echen8888/Project-NUEVO/docs/ros2/README.md

# ROS2 Docs

Workspace-level ROS2 documentation lives here.

Use these files for stack-level design, setup, and testing notes:

- [`ros2_nodes_design.md`](ros2_nodes_design.md)
- [`bridge_runtime.md`](bridge_runtime.md)
- [`rpi_setup.md`](rpi_setup.md)
- [`integration_test.md`](integration_test.md)
- [`troubleshooting.md`](troubleshooting.md)
- [`uart_tlv_test.md`](uart_tlv_test.md)
- [`vision_node.md`](vision_node.md)

Package-local READMEs stay next to their code under `ros2_ws/src/...`.
