echen8888/Project-NUEVO/plot.png

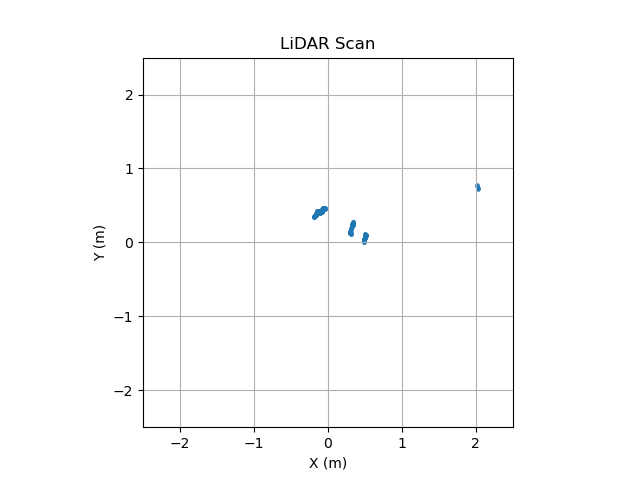
plot.png
