echen8888/Project-NUEVO/trajectory.png

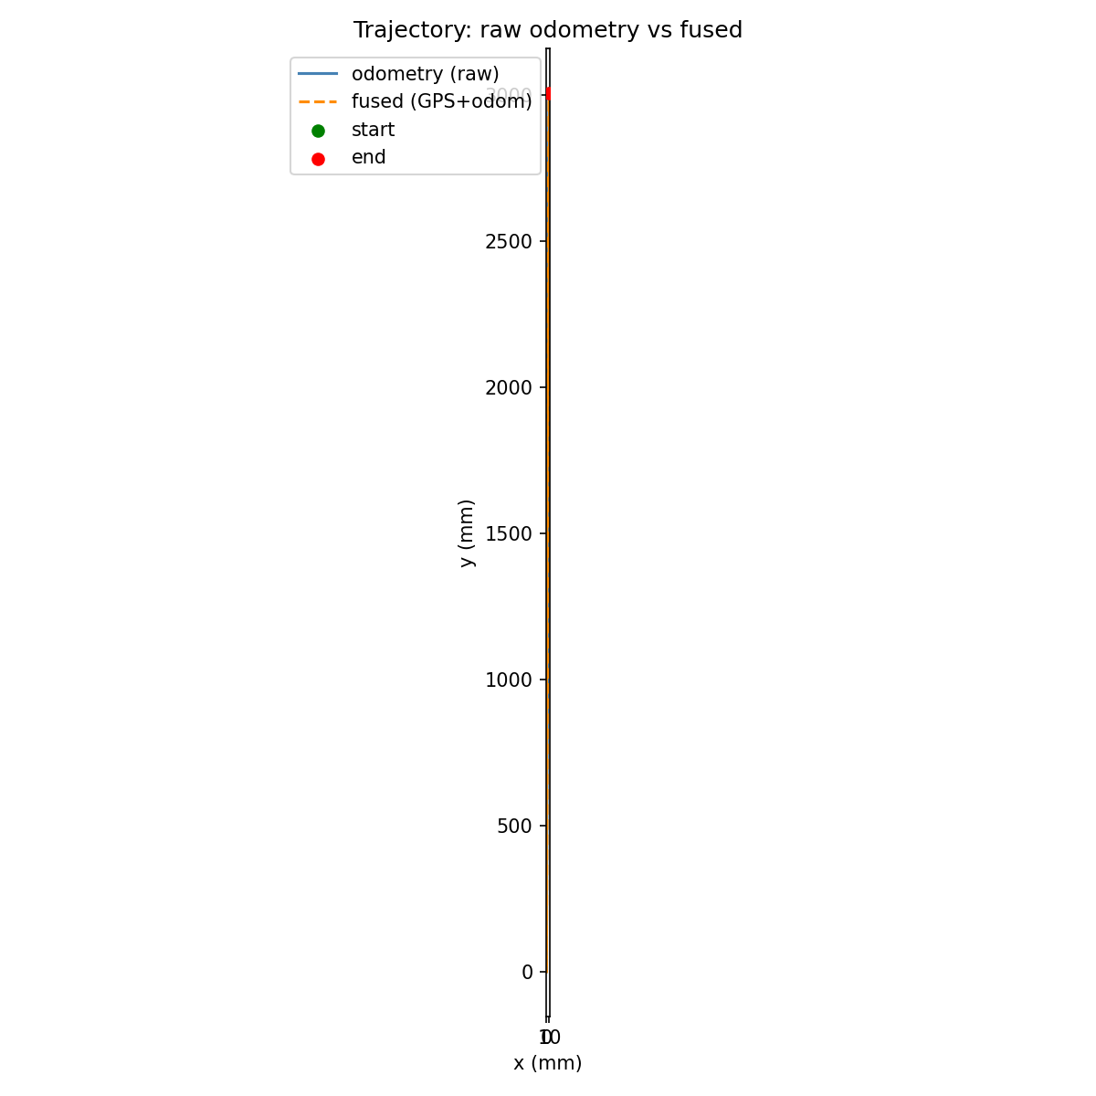
trajectory.png
