echen8888/Project-NUEVO/docs/lab_manual/Lab1_ROS2/lab1_manual_0.1.2.pdf

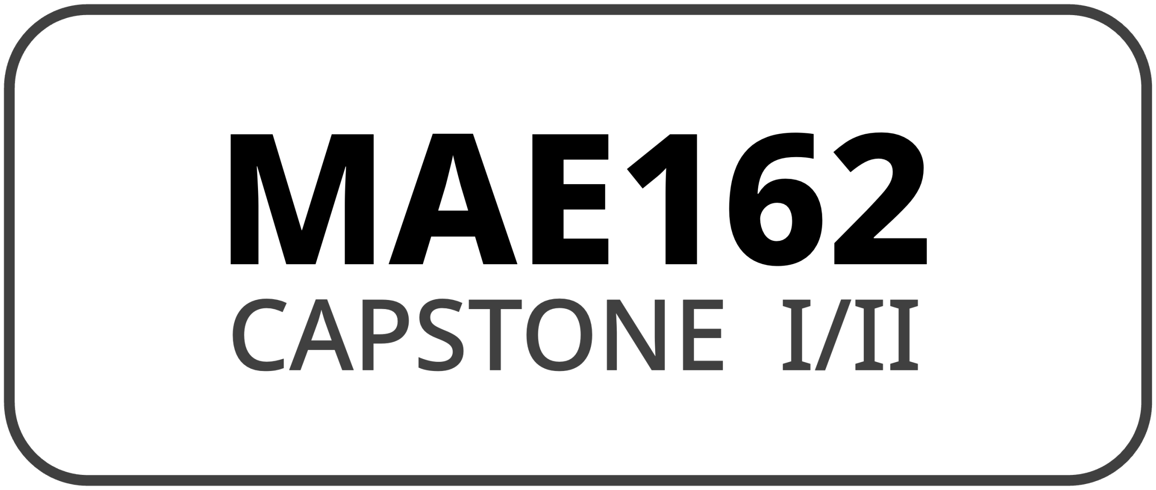
[picture p13: figure]

# Lab 1: ROS2 Introduction and System Integration

## Version 0.1.2

## 162 TAs and Maclab members

April 2, 2026

Warning!

- No food and drinks are allowed in the lab.
- Be careful with the hardware especially the electronics. Any liquid spill can cause a short circuit, potentially significantly delaying your progress.
- Never generate a short circuit.
- Connect electric wires only when you are sure about what you are doing.
- Be gentle to the buttons! You are liable to the damage made to the robot and its electronics.
- Wash your hands after each experiment, some components may contain some lead.
- Do not run experiments on the table for the chance the robot may fall on the floor and get damaged.

1

## Contents

1 System Architecture | 3
2 ROS2 Introduction | 6
3 Lab Activities | 8
3.3 Task 3: Bring Up the ROS2 Environment and NUEVO UI . . . . | 12
4 Lab Deliverables | 18

2

## 1 System Architecture

Figure 1 shows the full system architecture of Project NUEVO. The system is divided into several blocks that communicate over well-defined interfaces. Understanding this structure is essential for debugging and extending the robot. For a comprehensive reference covering all subsystems, see docs/manual/MANUAL.md. (https://github.com/pochihh/Project-NUEVO/blob/main/docs/manual/MANUAL.md)

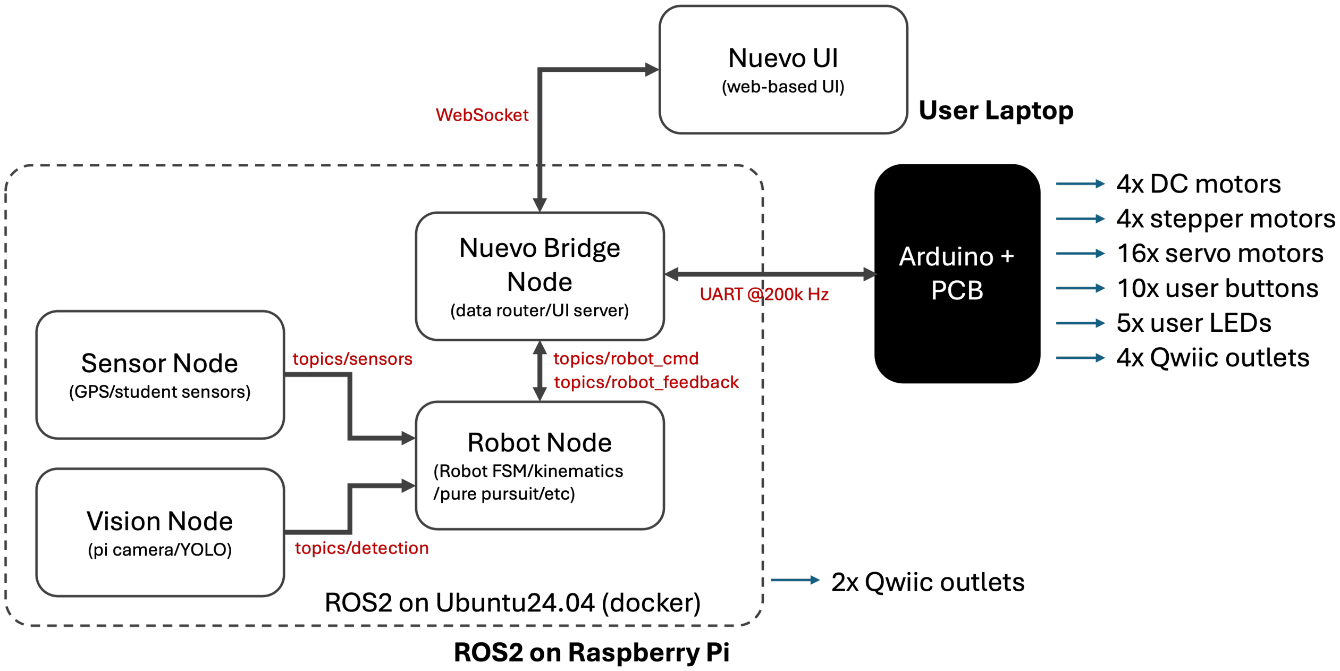
[picture p14: figure]

Figure 1: System Architecture.

PCB and Firmware

The custom PCB hosts an Arduino Mega 2560 microcontroller and breaks out the following hardware channels:

- 4 DC motor channels with quadrature encoder feedback
- 4 stepper motor channels (A4988/DRV8825 drivers)
- 16 servo channels via a PCA9685 I²C PWM controller
- IMU (ICM-20948: accelerometer, gyroscope, magnetometer)
- Voltage monitoring for the battery rail, 5 V rail, and servo rail
- User I/O: buttons, discrete LEDs, and NeoPixel RGB LEDs
- Limit switches and expandable ultrasonic sensor slots

3

The firmware is the only component that directly controls the actuators and reads hardware encoders; all other layers communicate with it through the bridge.

For full firmware details refer to:

- firmware/README.md (https://github.com/pochihh/Project-NUEVO/blob/main/firmware/README.md) — build, upload, and configuration overview
- firmware/arduino/src/config.h (https://github.com/pochihh/Project-NUEVO/blob/main/firmware/arduino/src/config.h) — all compile-time settings (channel counts, gains, rates)
- firmware/docs/architecture.md (https://github.com/pochihh/Project-NUEVO/blob/main/firmware/docs/architecture.md) — runtime task structure and startup order
- docs/COMMUNICATION_PROTOCOL.md (https://github.com/pochihh/Project-NUEVO/blob/main/docs/COMMUNICATION_PROTOCOL.md) — TLV protocol, message catalog, and state machine
- tlv_protocol/TLV_Payloads.md (https://github.com/pochihh/Project-NUEVO/blob/main/tlv_protocol/TLV_Payloads.md) — exact payload byte layouts and IDs

Bridge

The bridge is a Python process running on the Raspberry Pi 5. It owns the single UART connection to the Arduino (/dev/ttyAMA0 at 200 kbaud) and translates between the compact TLV wire protocol and higher-level interfaces. In addition to the transport layer, the bridge runs a FastAPI/WebSocket server that serves the NUEVO web UI. When running inside the ROS2 Docker container, the bridge also publishes and subscribes to ROS2 topics and services, acting as the boundary between the real-time firmware world and the robot application layer.

Refer to:

- ros2_ws/BRIDGE_RUNTIME.md (https://github.com/pochihh/Project-NUEVO/blob/main/ros2_ws/BRIDGE_RUNTIME.md) — bridge architecture, shared runtime model, and reset recovery
- docs/COMMUNICATION_PROTOCOL.md (https://github.com/pochihh/Project-NUEVO/blob/main/docs/COMMUNICATION_PROTOCOL.md) — TLV protocol, message catalog, and state machine

NUEVO UI

The NUEVO UI is a React web application served by the bridge backend. It provides a dashboard for testing and monitoring all hardware in real time:

4

motor speed setpoints and feedback, stepper positions, servo angles, LED color, user button states, IMU readings, voltage levels, and odometry. You access it from any browser on the same network by navigating to the Raspberry Pi’s IP address at port 8000.

Refer to:

- ros2_ws/README.md (https://github.com/pochihh/Project-NUEVO/blob/main/ros2_ws/README.md) — build instructions for the frontend and how to start the bridge that serves the UI

Robot Node

The robot ROS2 package is where high-level decision-making and path planning code lives. It subscribes to sensor and state topics published by the bridge, computes motion commands, and publishes velocity setpoints back to the bridge for execution. In this lab the robot node is a scaffold; you will extend it in future labs.

Sensor Node

The sensors ROS2 package handles Raspberry Pi–connected sensors that are not part of the Arduino firmware, such as GPS receivers and external range sensors (LiDAR, ultrasonic modules, etc.). It publishes sensor data as ROS2 topics for the robot node to consume.

Vision Node

The vision ROS2 package handles the camera pipeline and object detection. It reads frames from the camera, runs inference (e.g. YOLO), and publishes detection results as ROS2 topics. The vision dependencies (OpenCV, libcamera, YOLO) are heavier than the rest of the stack and are added to the Docker image separately.

Refer to the following for the Robot, Sensor, and Vision nodes:

- ros2_ws/ROS2_NODES_DESIGN.md (https://github.com/pochihh/Project-NUEVO/blob/main/ros2_ws/ROS2_NODES_DESIGN.md) — package layout, design principles, and topic/service naming
- ros2_ws/README.md (https://github.com/pochihh/Project-NUEVO/blob/main/ros2_ws/README.md) — Docker workflow, node startup order, and ROS2 API overview

5

Why ROS2 and Docker?

With this architecture, each component has a single responsibility and communicates through a standardised message-passing system. Adding a new sensor, planner, or perception algorithm means writing a new node that subscribes and publishes standard topics — the rest of the system does not change. Docker ensures that every team member and every Raspberry Pi runs the exact same software environment regardless of the host operating system, eliminating “it works on my machine” problems and making deployment to the robot a one-command step.

## 2 ROS2 Introduction

### 2.1 Core Concepts

ROS2 (Robot Operating System 2) is an open-source middleware framework for building robot software. Despite the name it is not an operating system: it is a set of libraries, tools, and conventions that run on top of a standard OS and let independently developed programs communicate with each other cleanly.

Nodes are the basic executable units. Each node is a process (or a thread within a process) that performs one focused task — reading a sensor, running a controller, publishing odometry. In this project: bridge, robot, sensor_node, and vision_node are each a separate node.

Topics are named communication channels that carry a stream of messages. A node that produces data publishes to a topic; a node that needs that data subscribes to it. Topics are asynchronous and many-to-many. For example, the bridge node publishes DC motor state on /dc_state_all and the robot node subscribes to that topic.

Messages define the data structure for a topic. They are declared in .msg files inside the bridge_interfaces package and compiled into languagespecific code automatically. bridge_interfaces/msg/DCStateAll and bridge_interfaces/msg/SystemPower are examples used in this project.

Services are synchronous request–reply interactions. A node that handles a service advertises it; another node calls it and waits for a response. Use services for discrete operations where you need to know whether the action

6

succeeded. In this project, firmware state transitions (IDLE → RUNNING, triggering an E-stop) use the /set_firmware_state service.

Packages are the unit of organisation and distribution. A package groups related nodes, message definitions, and launch files. This project has five packages: bridge_interfaces (message/service definitions), bridge (ROS wrapper around the firmware bridge), robot (motion planning), sensors (Pi-side sensors), and vision (camera and detection).

Keywords for further learning: ROS2 publisher/subscriber, colcon build, ros2 topic echo, ros2 node info, QoS policies, launch files, parameter server, tf2 transforms, RViz2, rqt.

### 2.2 Docker for ROS2

Modern robots are developed by teams working on different machines with different operating systems — macOS, Windows, Ubuntu. ROS2 Jazzy officially targets Ubuntu 24.04; running it natively on macOS or Windows requires significant manual setup that is fragile and hard to reproduce. Docker solves this by packaging the entire ROS2 environment — OS libraries, ROS installation, workspace build — into a single container image. Everyone on the team starts the same image, so the software environment is identical whether you are developing on a laptop or deploying to the Raspberry Pi. This also means updating the environment is a docker compose build rather than a multi-step manual procedure.

In this project the Docker image contains ROS2 Jazzy, the project workspace, and all Python runtime dependencies. Two compose files are provided:

- ros2_ws/docker/docker-compose.rpi.yml — for the Raspberry Pi with real hardware
- ros2_ws/docker/docker-compose.vm.yml — for macOS / Windows development (mock bridge)

Keywords for further learning: Dockerfile, Docker image vs. container, docker compose, volume mounts, container networking, docker exec, base images.

7

## 3 Lab Activities

### 3.1 Task 1: Set Up Your Repository

Where to run: | Laptop | your laptop | | RPi | Raspberry Pi | | The repo must be cloned
on both machines. Your laptop uses it for firmware (Task 2); the RPi uses it for ROS2 (Task 3). Day-to-day edits are made on your laptop, then pulled onto the RPi.

In this course you will modify the Project NUEVO codebase to add features and tune your robot. Each team should work in their own copy of the repository so that your changes do not affect other teams and so you can safely experiment.

### 1.1 Fork the Repository Laptop

1. Go to github.com/pochihh/Project-NUEVO.
2. Click Fork (top-right corner) to create a copy under your own GitHub
account. | (keyword: fork)
3. On your forked repository page, go to Settings → Collaborators and add your teammates as collaborators so everyone can push to the same
fork. | (keyword: collaborators, repository permissions)
1.2 Clone the Repository — Laptop | Laptop

Clone your fork onto your laptop. You will use this copy to edit firmware, run MATLAB, and push changes to GitHub.

git clone https://github.com/<your-username>/Project-NUEVO.git cd Project-NUEVO

(keyword: clone, remote)

### 1.3 Clone the Repository — Raspberry Pi RPi

SSH into the Raspberry Pi and clone the same fork there. The RPi copy is what Docker mounts when running the ROS2 workspace in Task 3.

8

git clone https://github.com/<your-username>/Project-NUEVO.git cd Project-NUEVO

You do not normally edit code directly on the RPi. The typical workflow is: edit on your laptop → commit → push to GitHub → git pull on the RPi to bring in the latest changes. You can make local changes on the RPi and push them back to GitHub if needed, but be careful not to let the two clones diverge—always pull on one machine before editing, and push promptly so your teammates stay in sync.

Important: the Raspberry Pi is embedded hardware and can lose power unexpectedly, suffer SD card corruption, or need to be re-imaged at any time. Any work that exists only on the RPi can be lost without warning. Push every change to GitHub as soon as you make it. Never leave uncommitted or unpushed work sitting on the RPi.

### 1.4 Daily Git Workflow Laptop

Git lets your whole team work on the same codebase simultaneously. Run these commands on your laptop:

1. Stage the files you want to save.

git add <filename>

(keyword: staging area, working tree)

2. Commit to record a snapshot with a short message describing what you did.

git commit -m "brief description of change"

(keyword: commit, commit message)

3. Push to upload your commits to GitHub so teammates (and the RPi) can see them.

9

git push

(keyword: push, origin)

4. Pull to download your teammates’ latest commits before you start working.

git pull

(keyword: pull, merge, rebase, merge conflict)

### 1.5 Pull Updates from the Original Repository Laptop

Bug fixes and new features will be released to the original repository during the course. To bring them into your fork, add the original repository as a second remote and pull from it:

1. Add the original repository as the upstream remote (one-time setup):

git remote add upstream https://github.com/pochihh/Project-NUEVO.git

(keyword: remote, upstream)

2. Fetch and merge the latest changes from upstream into your local branch (for updates in the future):

git fetch upstream
git merge upstream/main

(keyword: fetch, merge, fast-forward)

3. Push the merge result (the updates) to your fork:

git push

10

### 3.2 Task 2: Flash the Firmware

Where to run: | Laptop | your laptop | | Arduino IDE is installed on your laptop; the
Arduino is connected via USB.

The Arduino Mega firmware must be flashed onto the robot before the bridge can communicate with it. Full details and troubleshooting are in firmware/ README.md. (https://github.com/pochihh/Project-NUEVO/blob/main/firmware/README.md)

### 2.1 Prerequisites Laptop

1. Install Arduino IDE 2.x and the Arduino AVR Boards core.
2. Increase the serial buffer size so the firmware UART link does not overflow. Create or edit (if exists already) platform.local.txt for the installed AVR core and add the following text in it:

compiler.cpp.extra_flags=-DSERIAL_RX_BUFFER_SIZE=512 ,→ -DSERIAL_TX_BUFFER_SIZE=256

Typical file locations (replace 1.8.7 with your installed AVR core version):

macOS:

~/Library/Arduino15/packages/arduino/hardware/avr/1.8.7/platform.local. ⌋ ,→ txt

Windows:

C:\Users\<your-user>\AppData\Local\Arduino15\packages\arduino\hardware\ ⌋
,→ | avr\1.8.7\platform.local.txt
2.2 Build and Upload | Laptop
1. Open firmware/arduino/arduino.ino in Arduino IDE.
2. Select board: Arduino Mega or Mega 2560.

11

3. Select the correct COM / serial port for the connected Arduino.
4. Click Verify to confirm the firmware compiles without errors.
5. Click Upload to flash the firmware onto the board.

After a successful upload the board resets and the firmware starts running. Confirm by opening the Arduino IDE Serial Monitor at 115 200 baud and checking for heartbeat output.

### 3.3 Task 3: Bring Up the ROS2 Environment and NUEVO UI

Where to run: | RPi | Raspberry Pi (SSH or direct terminal) | | Steps 3.1–3.6 run
on the RPi. Step 3.7 opens in a browser on any device on the same network. Make sure you have already cloned your fork on the RPi (Task 1.3) and run git pull to get the latest code before starting.

In this task you will start the Docker container on the Raspberry Pi, launch the bridge node, and verify all hardware using the NUEVO web UI. Full setup details are in ros2_ws/README.md. (https://github.com/pochihh/Project-NUEVO/blob/main/ros2_ws/README.md)

### 3.1 Raspberry Pi UART Setup (one-time) RPi

The bridge communicates with the Arduino over the RPi hardware UART. Enable it by editing the RPi boot configuration files:

1. Add the following lines to /boot/firmware/config.txt:

enable_uart=1
dtoverlay=uart0-pi5
2. Remove any console=serial0 or console=ttyAMA0 entries from /boot/firmware/cmdline.txt so the OS does not claim the port.
3. Reboot and verify: ls -l /dev/ttyAMA0 should show a character device owned by the dialout group.

### 3.2 Install Node.js and npm (one-time) RPi

The NUEVO UI frontend build uses npm. Install Node.js and npm on the Raspberry Pi host first:

12

sudo apt update
sudo apt install -y nodejs npm node -v
npm -v

For this project, node -v should report a reasonably modern version (Node 18 or newer is a safe baseline).

### 3.3 Build the Frontend (one-time) RPi

The bridge serves the NUEVO web UI as a pre-built static bundle. Build it once from the repository root:

cd nuevo_ui/frontend
npm ci
npm run build
cd ../..
cp -r nuevo_ui/frontend/dist/. nuevo_ui/backend/static/

### 3.4 Install Docker (one-time) RPi

For this class project, the simplest Docker setup on the Raspberry Pi is the official Docker convenience script:

curl -fsSL https://get.docker.com -o get-docker.sh sudo sh get-docker.sh
sudo usermod -aG docker $USER
newgrp docker
docker --version
docker compose version

Note: if newgrp docker does not take effect cleanly in your shell, log out and log back in once, then re-run the version checks above.

13

### 3.5 Start the Docker Container RPi

From the repository root on the Raspberry Pi:

COMPOSE=ros2_ws/docker/docker-compose.rpi.yml docker compose -f $COMPOSE build
docker compose -f $COMPOSE up -d
docker compose -f $COMPOSE logs -f ros2_runtime

Wait until the log shows that colcon build finished and the container is ready.

### 3.6 Launch the Bridge Node RPi

Open a shell inside the running container and start the bridge:

docker compose -f $COMPOSE exec ros2_runtime bash source /opt/ros/jazzy/setup.bash
source /ros2_ws/install/setup.bash
ros2 run bridge bridge

The bridge node connects to the Arduino, starts the WebSocket server, and begins publishing ROS2 topics.

### 3.7 Access the NUEVO UI UI (browser)

Open a browser on any device on the same network and navigate to:

http://<raspberry-pi-ip>:8000

Login credentials: username user, password 162. Change your password after first login.

Use the UI to test each hardware feature:

- Set stepper motor positions and verify movement.
- Command servo angles and observe the mechanical response.
- Change LED colors via the colour picker.
| 14

- Press each user button and confirm the indicator updates.
- Check IMU readings (accelerometer, gyroscope) for expected values.
- Monitor the battery voltage level on the power panel.

### 3.4 Task 4: DC Motor PI Tuning and Step Response

Where to run: | Laptop | your laptop | | UI (browser) | NUEVO UI | | RPi | RPi | | MATLAB
analysis and gain calculations run on your laptop. Motor commands and data recording use the NUEVO UI in your browser. The RPi must be running the bridge node from Task 3.

In this task you will tune the PI velocity controller for one DC motor and record step responses to evaluate your design. The goal is to transition from the default gains to a set of gains that you can justify from a simple model of the motor dynamics.

4.1 Model-Based PI Design (Optional) | UI (browser) | Laptop

A DC motor’s velocity dynamics can be approximated as a first-order linear system:
G(s) = | K
| | | τs + 1 | | | | (1)

where K is the steady-state gain (ticks/s per PWM unit) and τ is the time constant (seconds). You can identify both parameters from an open-loop step response.

Step 1: Measure the open-loop step response. In the NUEVO UI, switch the motor to PWM mode and apply a step change in PWM from 0 to a fixed value (e.g. 128 out of 255, or about 50 %). Record the velocity ω(t) response using the UI’s plot feature.

From the recorded curve:

- K = ωss/u where u is the actual integer PWM value you applied (0–255, not 1). For example, if you applied PWM = 128 and the motor settled at ωss = 980 ticks/s, then K = 980/128 ≈ 7.66 ticks/s per PWM unit.
- τ = the time at which ω(t) first reaches 63.2 % of ωss (read directly from the step-response plot).
| | | 15

Step 2: Design the continuous-time PI gains. A PI controller C(s) = Kp + Ki/s with plant G(s) gives a second-order closed-loop response. Matching coefficients to the standard form s

2 + 2ζωns + ω

2
n

yields:

Kp =

2ζωnτ − 1
K

, Ki =

ω

2
n

τ
K

(2)

Choose a desired damping ratio ζ = 0.7 (a good default that balances speed and overshoot). Select ωn based on a rise-time or settling-time specification of your choice, then compute Kp and Ki from Equations (2).

Step 3: Convert to discrete time. The firmware PI controller runs at fs = 200 Hz, so the sample period is Ts = 1/200 = 0.005 s. Because the gains from Step 2 are continuous-time, they must be discretized before they can be entered into the firmware. Use the Tustin (bilinear) transform, which substitutes
s −→
2 Ts | z − 1 z + 1

and maps the continuous-time PI controller to a discrete difference equation. In MATLAB, the conversion is one line:

Ts = 0.005; | % sample period (s) -- 200 Hz
C_s = pid(Kp, Ki); | % continuous-time PI
C_z = c2d(C_s, Ts, 'tustin'); | % discretize via bilinear transform
display(C_z) | % inspect the result

The resulting C_z object contains the discrete-time coefficients. You can extract the numerator and denominator and verify the DC gain matches Kp + Ki/(jω) at low frequency. The firmware implements the equivalent difference equation internally; you only need to enter Kp and Ki (the continuous-time values) through the UI—the firmware’s built-in discretization handles the rest at runtime.

### 4.2 Simple Observation (Alternative to 4.1) UI (browser)

If you prefer a faster approach, skip the model identification and instead adjust Kp and Ki manually while observing the step response: increase Kp to speed up the response, increase Ki to eliminate steady-state error, and reduce both if the response oscillates.

16

4.3 Record and Compare Step Responses | UI (browser) | Laptop

Using the NUEVO UI, command a velocity step from 0 to 1000 ticks/s and record the response for:

1. The default PI gains (as shipped in firmware/arduino/src/ config.h).
2. Your tuned gains from Task 4.1 or 4.2.

On each plot, annotate:

- Rise time tr (time to go from 10 % to 90 % of the setpoint)
- Percent overshoot Mp
- Settling time ts (time to stay within ±5 % of the setpoint)
- Steady-state error ess

Figure 2 shows an example plot.


Figure 2: Example annotated velocity step response (0 → 1000 ticks/s). The shaded region is the ±5 % settling band.

17

## 4 Lab Deliverables

Show your final step response plots to the TAs. Your plots should include both the default and tuned step responses with the performance metrics annotated. Justify your tuned gains: explain how you arrived at your Kp and Ki values, whether through the model-based approach or manual tuning, and discuss the trade-offs you observed between rise time, overshoot, and settling time.

18
