echen8888/Project-NUEVO/docs/lab_manual/Lab1_ROS2/dc_motor_1_0331_15-28_step_response.png

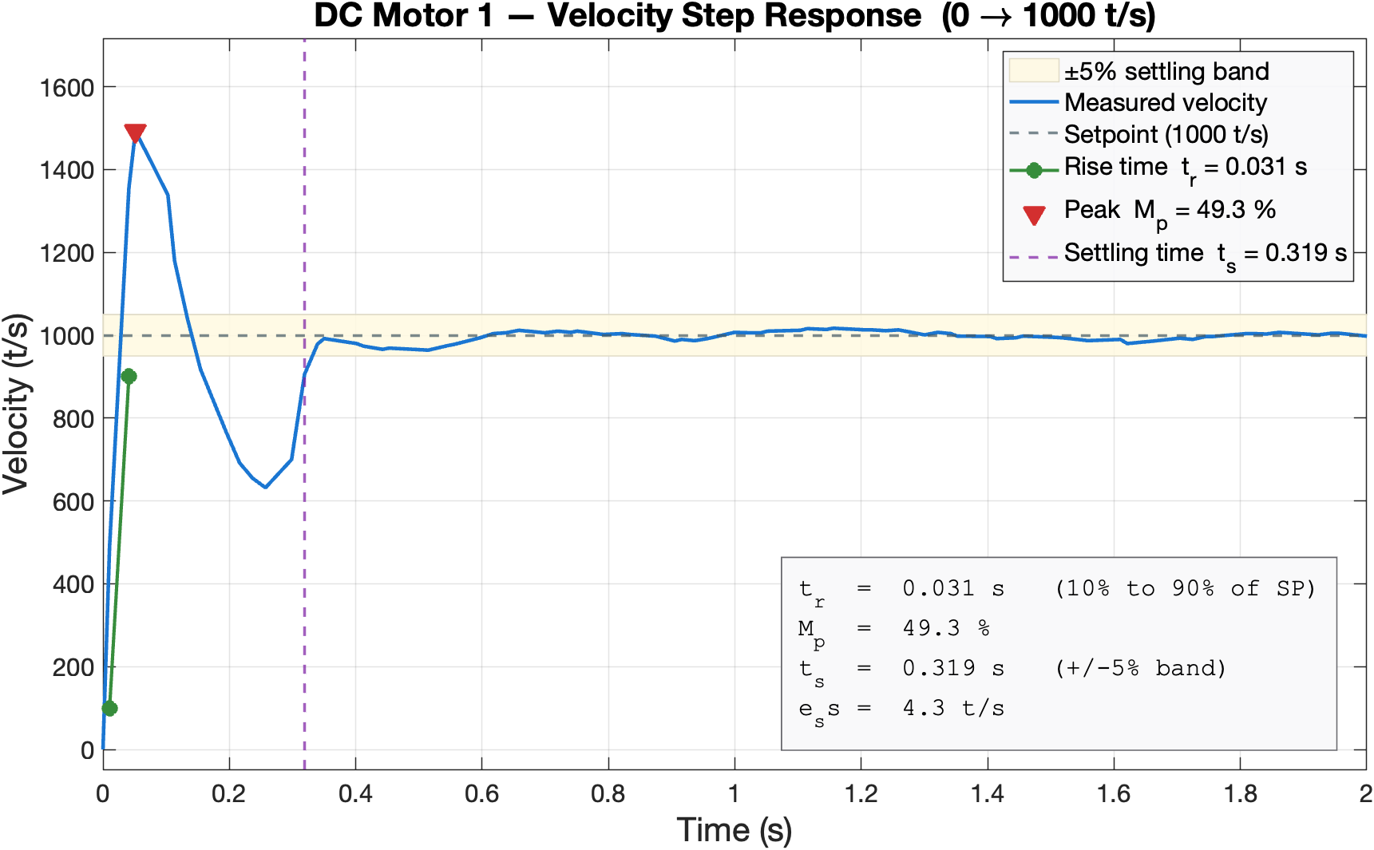
docs/lab_manual/Lab1_ROS2/dc_motor_1_0331_15-28_step_response.png
