echen8888/Project-NUEVO/orientation_fusion_test_result.png

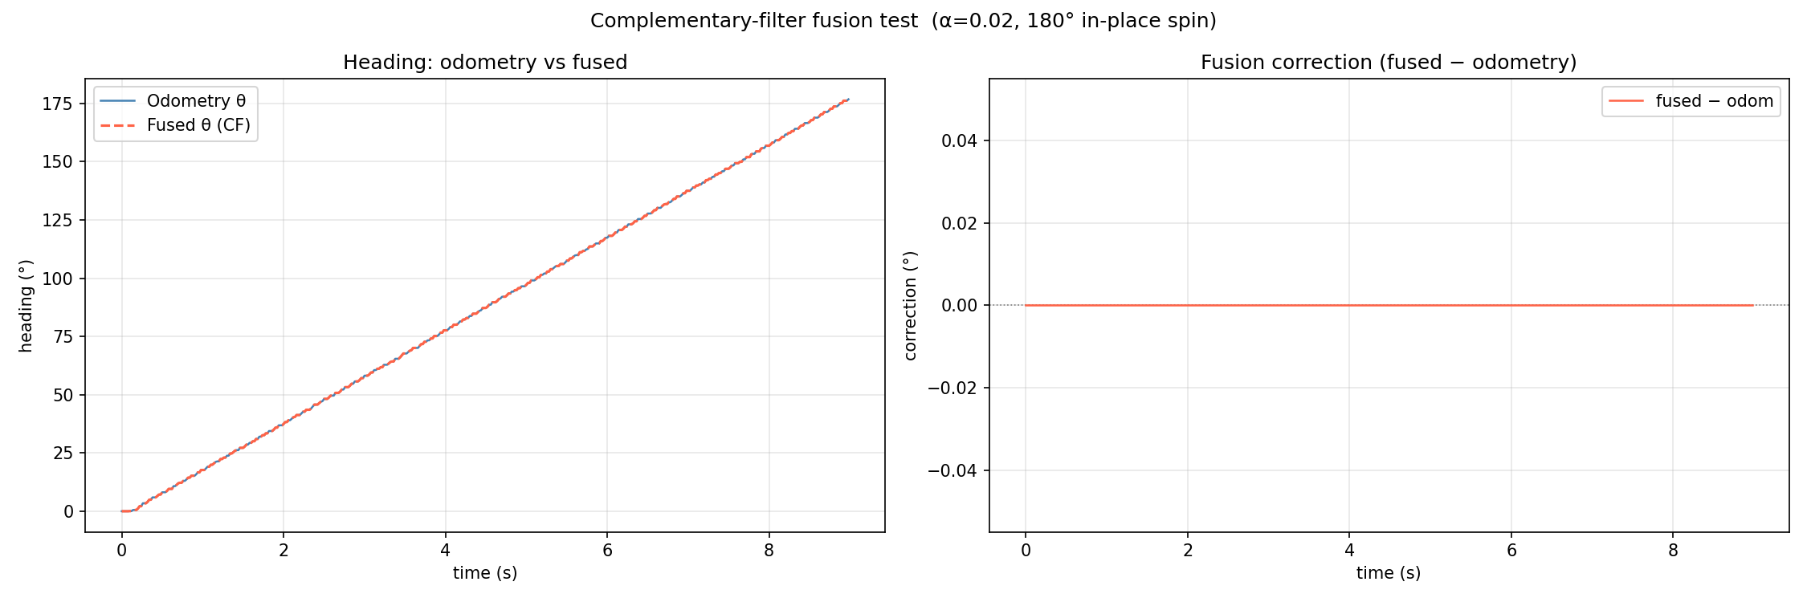
orientation_fusion_test_result.png
