echen8888/Project-NUEVO/ros2_ws/src/robot/robot/ai_codegen/test_UML.png

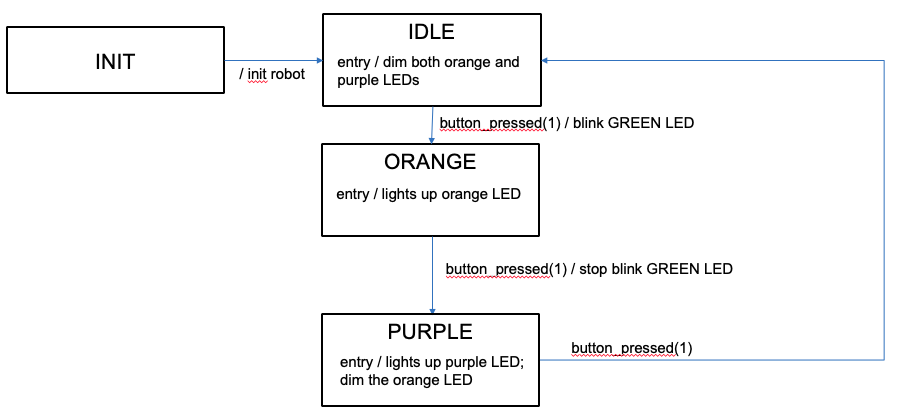
ros2_ws/src/robot/robot/ai_codegen/test_UML.png
