echen8888/Project-NUEVO/(commit log)

2026-01-28 updated UART python test code
2026-03-25 frontend motor overrun indication fix
2026-04-04 Add odom param query/response across the bridge, ROS, and UI. Expose the runtime odometry config in the robot API and odometry panel.
2026-04-04 Document the odom param query path. Clarify the odometry task cadence and the new robot API readback calls.
2026-04-08 Fix robot odometry parameter names and lab setup
    [main.py]
2026-04-19 New pi camera streaming solution first try. See "v4l2_loopback_camera_plan.md" for the plan details
2026-04-22 Use YOLO26n NCNN for vision node
    [model.ncnn.param, yolov4.cfg]
2026-05-01 add FusedPose and LidarWorldPoints message types
    New bridge_interfaces messages for the lidar canvas and GPS fusion UI:
    - FusedPose: world-frame x/y/theta + gps_active flag
    - LidarWorldPoints: parallel float arrays for efficient world-frame scan relay
2026-05-01 fix sensor_msgs import fallback and test module path
    - robot.py: wrap sensor_msgs.msg.LaserScan import in try/except so the
    module loads cleanly in non-ROS test environments
    - test_position_fusion_runtime.py: update import path from stale
    robot.test_position_fusion to robot.examples.position_fusion_demo
    [robot.py, test_position_fusion_runtime.py]
2026-05-01 phase 6: bridge relay for fused_pose, lidar_world_points, gps_status, ros_nodes
    - Subscribe to /fused_pose, /lidar_world_points (BEST_EFFORT), /tag_detections
    - Forward each as WebSocket message to connected browser clients
    - gps_status.is_detected goes false after 1 s without tag detection
    - 1.5 Hz timer broadcasts ros_nodes (node names + pub/sub topic lists)
    - Thread-safe: asyncio.run_coroutine_threadsafe from ROS spin thread
2026-05-01 OdometryCard: compact layout — X/Y/θ one row, Vx/Vy one row, wheel params grouped
2026-05-01 WorldCanvas: fused=blue, odom=green, GPS=yellow cross; bridge /odometry relay; vm_demo odometry drift + moving GPS
    - WorldCanvas: swap trail colors (fused→blue #60a5fa, odom→green #4ade80), GPS dot→yellow + cross
    - bridge_node: subscribe to /odometry (SensorKinematics), relay as sensor_kinematics WS topic so odometryTrail populates
    - vm_demo: publish /odometry with per-lap outward drift so odom trail visibly diverges from fused; GPS tag orbits at 900mm/35s instead of fixed point
    - LIDAR_WINDOW_FRAMES reduced to 3
    [bridge_node.py, vm_demo.py]
2026-05-03 Firmware: preserve Timer2 PWM setup for M3/M4
